adamgreen/NeoPixelTree/images/20181011-01.gif

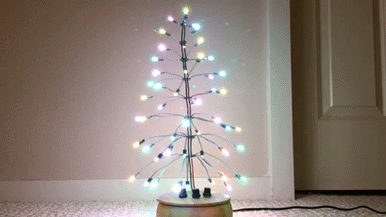
images/20181011-01.gif
