adamgreen/NeoPixelTree/images/20160401-01.JPG

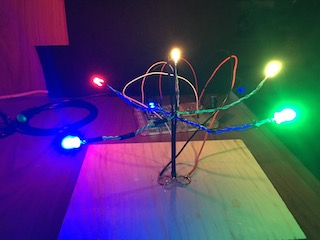
images/20160401-01.JPG
