adamgreen/NeoPixelTree/docs/AdafruitLabelledPhotoOf5mmNeoPixelLED_1938-05.jpg

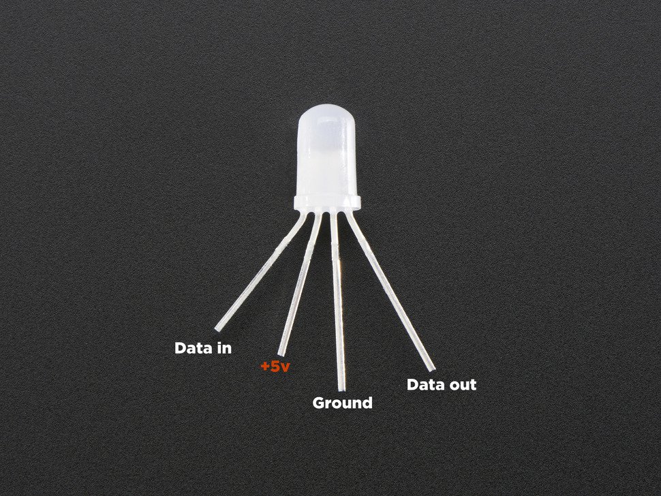
docs/AdafruitLabelledPhotoOf5mmNeoPixelLED_1938-05.jpg
