adamgreen/NeoPixelTree/hardware/Prototype.png

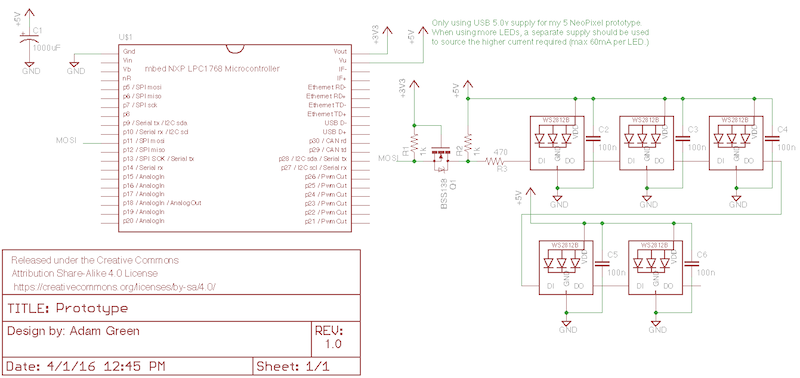
hardware/Prototype.png
