adamgreen/NeoPixelTree/images/20160401-02.GIF

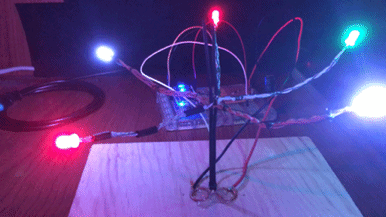
images/20160401-02.GIF
