adamgreen/NeoPixelTree/images/20160407-01.png

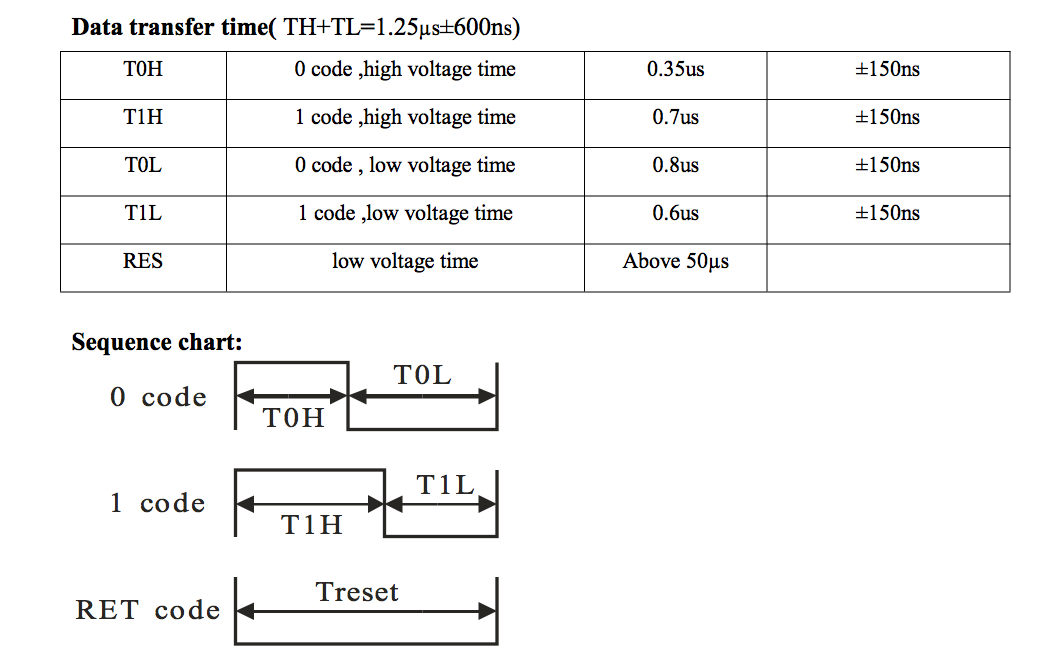
images/20160407-01.png
