adamgreen/NeoPixelTree/images/20160407-02.png

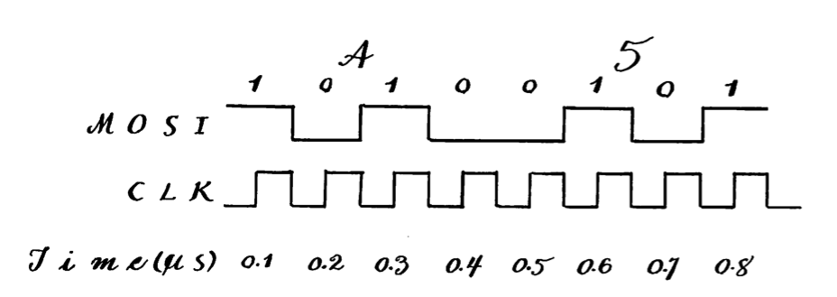
images/20160407-02.png
