adamgreen/NeoPixelTree/images/20160407-03.png

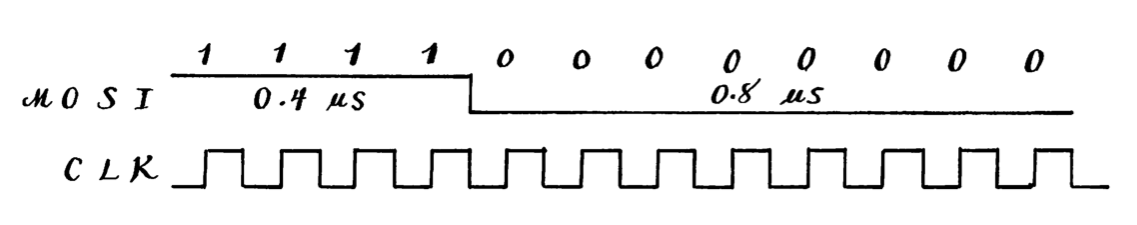
images/20160407-03.png
