adamgreen/NeoPixelTree/hardware/Prototype.pdf

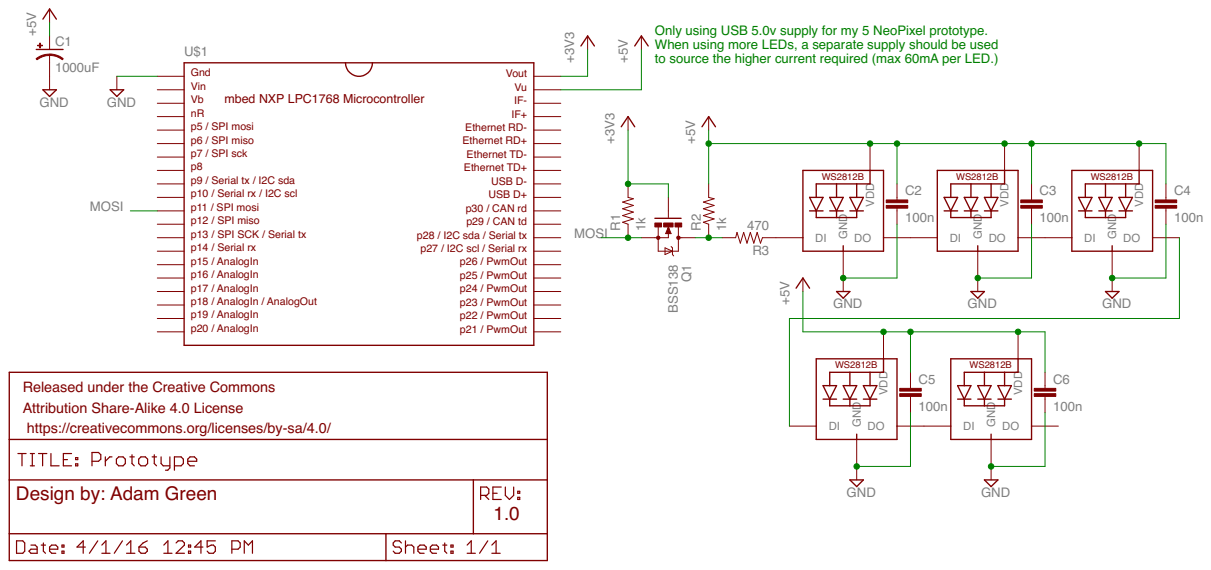
[picture p9: page 1]

Only using USB 5.0v supply for my 5 NeoPixel prototype. When using more LEDs, a separate supply should be used

to source the higher current required (max 60mA per LED.)

p5 / SPI mosi p6 / SPI miso

IF+ Ethernet RD- Ethernet RD+ Ethernet TD- Ethernet TD+ USB D- USB D+

p9 / Serial tx / I2C sda
p10 / Serial rx / I2C scl p11 / SPI mosi p12 / SPI miso

p21 / PwmOut p22 / PwmOut p23 / PwmOut p24 / PwmOut p25 / PwmOut p26 / PwmOut p27 / I2C scl / Serial rx p28 / I2C sda / Serial tx p29 / CAN td

p13 / SPI SCK / Serial tx p14 / Serial rx p15 / AnalogIn

https://creativecommons.org/licenses/by-sa/4.0/ Design by: Adam Green
