adamgreen/NeoPixelTree/hardware/TrunkBus5.brd

## EAGLE design hardware/TrunkBus5.brd (2018-04-29)

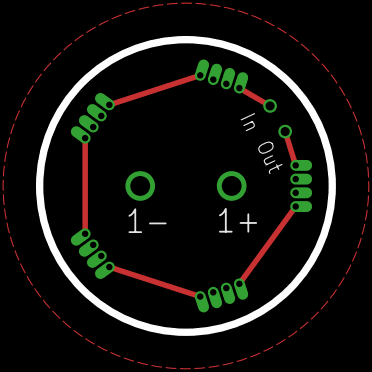
[picture p10: board TrunkBus5.brd from above]

Board: 2 copper layers, 16.3 x 16.3 mm, 8 parts (0 on the bottom side), 8 nets.

Parts:
E$1: NEOPIXEL_TRUNK_2WIRE
E$5, E$6, E$7, E$8, E$10: NEOPIXEL_BRANCH_4WIRE
E$12, E$13: NEOPIXEL_26AWG_HOLE

Connections:
5V: E$1.P$1, E$5.P$1, E$6.P$1, E$7.P$1, E$8.P$1, E$10.P$1
GND: E$1.P$2, E$5.P$2, E$6.P$2, E$7.P$2, E$8.P$2, E$10.P$2
S$1: E$8.P$4, E$10.P$3
S$2: E$10.P$4, E$12.P$1
S$4: E$5.P$3, E$13.P$1
S$7: E$5.P$4, E$6.P$3
S$8: E$6.P$4, E$7.P$3
S$10: E$7.P$4, E$8.P$3
