adamgreen/NeoPixelTree/hardware/TrunkBus3.brd

## EAGLE design hardware/TrunkBus3.brd (2018-04-29)

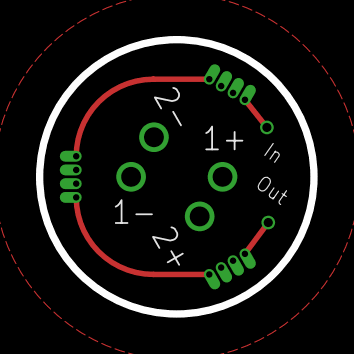
[picture p11: board TrunkBus3.brd from above]

Board: 2 copper layers, 15.2 x 15.2 mm, 7 parts (0 on the bottom side), 6 nets.

Parts:
E$1, E$11: NEOPIXEL_TRUNK_2WIRE
E$2, E$6, E$8: NEOPIXEL_BRANCH_4WIRE
E$12, E$13: NEOPIXEL_26AWG_HOLE

Connections:
5V: E$1.P$1, E$2.P$1, E$6.P$1, E$8.P$1, E$11.P$1
GND: E$1.P$2, E$2.P$2, E$6.P$2, E$8.P$2, E$11.P$2
S$1: E$8.P$4, E$12.P$1
S$2: E$2.P$3, E$13.P$1
S$4: E$2.P$4, E$6.P$3
S$8: E$6.P$4, E$8.P$3
