adamgreen/NeoPixelTree/hardware/LedHolder.brd

## EAGLE design hardware/LedHolder.brd (2018-03-23)

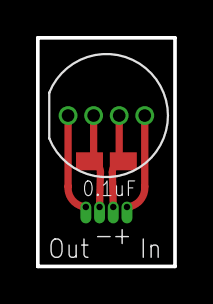
[picture p12: board LedHolder.brd from above]

Board: 2 copper layers, 7.6 x 12.7 mm, 3 parts (0 on the bottom side), 4 nets.

Parts:
E$1: NEOPIXEL_5MM_TH
E$2: NEOPIXEL_BRANCH_4WIRE
E$3: 0.1uF; R0805W

Connections:
S$1: E$1.GROUND, E$2.P$1, E$3.1
S$2: E$1.5V, E$2.P$2, E$3.2
S$3: E$1.DATA_OUT, E$2.P$3
S$4: E$1.DATA_IN, E$2.P$4
