adamgreen/NeoPixelTree/firmware/main.cpp

/* Copyright (C) 2018  Adam Green (https://github.com/adamgreen)

   Licensed under the Apache License, Version 2.0 (the "License");
   you may not use this file except in compliance with the License.
   You may obtain a copy of the License at

       http://www.apache.org/licenses/LICENSE-2.0

   Unless required by applicable law or agreed to in writing, software
   distributed under the License is distributed on an "AS IS" BASIS,
   WITHOUT WARRANTIES OR CONDITIONS OF ANY KIND, either express or implied.
   See the License for the specific language governing permissions and
   limitations under the License.
*/
#include <mbed.h>
#include "Animation.h"
#include "Encoders.h"
#include "NeoPixel.h"


#define LED_COUNT                           50
#define SECONDS_BETWEEN_ANIMATION_SWITCH    30
#define DUMP_COUNTERS                       0

#define BRIGHTNESS_MIN                      1
#define BRIGHTNESS_MAX                      255
#define BRIGHTNESS_DEFAULT                  128
#define BRIGHTNESS_DELTA                    1

#define DELAY_MIN                           125
#define DELAY_MAX                           1000
#define DELAY_DEFAULT                       250
#define DELAY_DELTA                         5

#define ARRAY_SIZE(X) (sizeof(X)/sizeof(X[0]))

// The animations that I currently have defined for this sample.
enum Animations
{
    Solid_White,
    Solid_Red,
    Solid_Green,
    Solid_Blue_White,
    Solid_Red_Green,
    Solid_Red_Green_White,
    Solid_Red_Orange_Yellow_Green_Blue,
    Chase_Blue_White,
    Chase_Red_Green,
    Chase_Red_Green_White,
    Chase_Red_Orange_Yellow_Green_Blue,
    Throbbing_Red,
    Throbbing_Green,
    Throbbing_White,
    Fade_Blue_White,
    Fade_Red_Green,
    Fade_Red_Green_White,
    Fade_Red_Orange_Yellow_Green_Blue,
    Fade_Rainbow,
    Twinkle_White,
    Twinkle_Red,
    Twinkle_Green,
    Twinkle_AnyColor,
    Twinkle_Snow,
    Running_Lights,
    Meteor,
    Candle_Flicker,
    Max_Animation
};

// Should we advance to next or previous animation.
enum AdvanceMode
{
    Advance_Next,
    Advance_Prev
};

static Animations        g_currAnimation = Solid_White;
static bool              g_demoMode = true;
static IPixelUpdate*     g_pPixelUpdate;
static int16_t           g_brightness = BRIGHTNESS_DEFAULT;
static int32_t           g_delay = DELAY_DEFAULT;
static Encoder           g_encoderPattern(p11, p12, p17);
static Encoder           g_encoderSpeed(p13, p14, p18);
static Encoder           g_encoderBrightness(p15, p16, p19);


// Function Prototypes.
static void updateAnimation();
static void advanceToNextAnimation(AdvanceMode advance);


int main()
{
    uint32_t lastFlipCount = 0;
    uint32_t lastSetCount = 0;
    static   DigitalOut myled(LED1);
    static   NeoPixel   ledControl(LED_COUNT, p5);
    static   Timer      timer;
    static   Timer      ledTimer;

    updateAnimation();
    ledControl.start();

    timer.start();
    ledTimer.start();

    while(1)
    {
        if (timer.read_ms() > SECONDS_BETWEEN_ANIMATION_SWITCH * 1000)
        {
            uint32_t currSetCount = ledControl.getSetCount();
            uint32_t setCount =  currSetCount - lastSetCount;
            uint32_t currFlipCount = ledControl.getFlipCount();
            uint32_t flipCount = currFlipCount - lastFlipCount;

            if (DUMP_COUNTERS)
            {
                printf("flips: %lu/sec    sets: %lu/sec\n",
                       flipCount / SECONDS_BETWEEN_ANIMATION_SWITCH,
                       setCount / SECONDS_BETWEEN_ANIMATION_SWITCH);
            }

            timer.reset();
            lastSetCount = currSetCount;
            lastFlipCount = currFlipCount;

            // Only advance to next animation if in demo mode.
            if (g_demoMode)
            {
                advanceToNextAnimation(Advance_Next);
            }
        }
        g_pPixelUpdate->updatePixels(ledControl);

        if (ledTimer.read_ms() >= 250)
        {
            myled = !myled;
            ledTimer.reset();
        }

        EncoderState state;
        if (g_encoderPattern.sample(&state))
        {
            if (state.count > 0)
            {
                g_demoMode = false;
                advanceToNextAnimation(Advance_Next);
            }
            else if (state.count < 0)
            {
                g_demoMode = false;
                advanceToNextAnimation(Advance_Prev);
            }
            if (state.isPressed)
            {
                g_demoMode = true;
            }
        }

        if (g_encoderSpeed.sample(&state))
        {
            // Increasing count on speed encoder will cause a decrease in delay so the logic is inverted from the
            // other encoders.
            if (state.count < 0)
            {
                g_delay -= DELAY_DELTA * state.count;
                if (g_delay > DELAY_MAX)
                {
                    g_delay = DELAY_MAX;
                }
            }
            else if (state.count > 0)
            {
                g_delay -= DELAY_DELTA * state.count;
                if (g_delay < DELAY_MIN)
                {
                    g_delay = DELAY_MIN;
                }
            }
            if (state.isPressed)
            {
                g_delay = DELAY_DEFAULT;
            }

            updateAnimation();
        }

        if (g_encoderBrightness.sample(&state))
        {
            if (state.count > 0)
            {
                g_brightness += BRIGHTNESS_DELTA * state.count;
                if (g_brightness > BRIGHTNESS_MAX)
                {
                    g_brightness = BRIGHTNESS_MAX;
                }
            }
            else if (state.count < 0)
            {
                g_brightness += BRIGHTNESS_DELTA * state.count;
                if (g_brightness < BRIGHTNESS_MIN)
                {
                    g_brightness = BRIGHTNESS_MIN;
                }
            }
            if (state.isPressed)
            {
                g_brightness = BRIGHTNESS_DEFAULT;
            }

            updateAnimation();
        }
    }
}

static void updateAnimation()
{
    static Animation<LED_COUNT>        animation;
    static TwinkleAnimation<LED_COUNT> twinkle;
    static TwinkleProperties           twinkleProperties;
    static FlickerAnimation<LED_COUNT> flicker;
    static FlickerProperties           flickerProperties;
    static RunningLightsAnimation<LED_COUNT> runningLights;
    static MeteorProperties            meteorProperties;
    static MeteorAnimation<LED_COUNT>  meteor;
    static RGBData                     pixels1[LED_COUNT];
    static RGBData                     pixels2[LED_COUNT];
    static RGBData                     pixels3[LED_COUNT];
    static RGBData                     pixels4[LED_COUNT];
    static RGBData                     pixels5[LED_COUNT];
    static AnimationKeyFrame           keyFrames[5];

    // Use the natural logarithm of brightness setting to create a smoother gradient.
    uint8_t brightness = logOfBrightness(g_brightness);

    switch (g_currAnimation)
    {
    case Solid_White:
        {
            RGBData pattern[] = { WHITE };
            changeBrightness(pattern, ARRAY_SIZE(pattern), brightness);
            createRepeatingPixelPattern(pixels1, ARRAY_SIZE(pixels1), pattern, ARRAY_SIZE(pattern));
            keyFrames[0] = {pixels1, 0x7FFFFFFF, false};
            animation.setKeyFrames(keyFrames, 1);
            g_pPixelUpdate = &animation;
            break;
        }
    case Solid_Red:
        {
            RGBData pattern[] = { RED };
            changeBrightness(pattern, ARRAY_SIZE(pattern), brightness);
            createRepeatingPixelPattern(pixels1, ARRAY_SIZE(pixels1), pattern, ARRAY_SIZE(pattern));
            keyFrames[0] = {pixels1, 0x7FFFFFFF, false};
            animation.setKeyFrames(keyFrames, 1);
            g_pPixelUpdate = &animation;
            break;
        }
    case Solid_Green:
        {
            RGBData pattern[] = { GREEN };
            changeBrightness(pattern, ARRAY_SIZE(pattern), brightness);
            createRepeatingPixelPattern(pixels1, ARRAY_SIZE(pixels1), pattern, ARRAY_SIZE(pattern));
            keyFrames[0] = {pixels1, 0x7FFFFFFF, false};
            animation.setKeyFrames(keyFrames, 1);
            g_pPixelUpdate = &animation;
            break;
        }
    case Solid_Blue_White:
        {
            RGBData pattern[] = { BLUE, WHITE };
            changeBrightness(pattern, ARRAY_SIZE(pattern), brightness);
            createRepeatingPixelPattern(pixels1, ARRAY_SIZE(pixels1), pattern, ARRAY_SIZE(pattern));
            keyFrames[0] = {pixels1, 0x7FFFFFFF, false};
            animation.setKeyFrames(keyFrames, 1);
            g_pPixelUpdate = &animation;
            break;
        }
    case Solid_Red_Green:
        {
            RGBData pattern[] = { RED, GREEN };
            changeBrightness(pattern, ARRAY_SIZE(pattern), brightness);
            createRepeatingPixelPattern(pixels1, ARRAY_SIZE(pixels1), pattern, ARRAY_SIZE(pattern));
            keyFrames[0] = {pixels1, 0x7FFFFFFF, false};
            animation.setKeyFrames(keyFrames, 1);
            g_pPixelUpdate = &animation;
            break;
        }
    case Solid_Red_Green_White:
        {
            RGBData pattern[] = { RED, GREEN, WHITE };
            changeBrightness(pattern, ARRAY_SIZE(pattern), brightness);
            createRepeatingPixelPattern(pixels1, ARRAY_SIZE(pixels1), pattern, ARRAY_SIZE(pattern));
            keyFrames[0] = {pixels1, 0x7FFFFFFF, false};
            animation.setKeyFrames(keyFrames, 1);
            g_pPixelUpdate = &animation;
            break;
        }
    case Solid_Red_Orange_Yellow_Green_Blue:
        {
            RGBData pattern[] = { RED, DARK_ORANGE, YELLOW, GREEN, BLUE };
            changeBrightness(pattern, ARRAY_SIZE(pattern), brightness);
            createRepeatingPixelPattern(pixels1, ARRAY_SIZE(pixels1), pattern, ARRAY_SIZE(pattern));
            keyFrames[0] = {pixels1, 0x7FFFFFFF, false};
            animation.setKeyFrames(keyFrames, 1);
            g_pPixelUpdate = &animation;
            break;
        }
    case Chase_Blue_White:
        {
            RGBData pattern1[] = { BLUE, WHITE };
            RGBData pattern2[] = { WHITE, BLUE };
            changeBrightness(pattern1, ARRAY_SIZE(pattern1), brightness);
            changeBrightness(pattern2, ARRAY_SIZE(pattern2), brightness);
            createRepeatingPixelPattern(pixels1, ARRAY_SIZE(pixels1), pattern1, ARRAY_SIZE(pattern1));
            createRepeatingPixelPattern(pixels2, ARRAY_SIZE(pixels2), pattern2, ARRAY_SIZE(pattern2));
            keyFrames[0] = {pixels1, g_delay, false};
            keyFrames[1] = {pixels2, g_delay, false};
            animation.setKeyFrames(keyFrames, 2);
            g_pPixelUpdate = &animation;
            break;
        }
    case Chase_Red_Green:
        {
            RGBData pattern1[] = { RED, GREEN };
            RGBData pattern2[] = { GREEN, RED };
            changeBrightness(pattern1, ARRAY_SIZE(pattern1), brightness);
            changeBrightness(pattern2, ARRAY_SIZE(pattern2), brightness);
            createRepeatingPixelPattern(pixels1, ARRAY_SIZE(pixels1), pattern1, ARRAY_SIZE(pattern1));
            createRepeatingPixelPattern(pixels2, ARRAY_SIZE(pixels2), pattern2, ARRAY_SIZE(pattern2));
            keyFrames[0] = {pixels1, g_delay, false};
            keyFrames[1] = {pixels2, g_delay, false};
            animation.setKeyFrames(keyFrames, 2);
            g_pPixelUpdate = &animation;
            break;
        }
    case Chase_Red_Green_White:
        {
            RGBData pattern1[] = { RED, GREEN, WHITE };
            RGBData pattern2[] = { WHITE, RED, GREEN };
            RGBData pattern3[] = { GREEN, WHITE, RED };
            changeBrightness(pattern1, ARRAY_SIZE(pattern1), brightness);
            changeBrightness(pattern2, ARRAY_SIZE(pattern2), brightness);
            changeBrightness(pattern3, ARRAY_SIZE(pattern3), brightness);
            createRepeatingPixelPattern(pixels1, ARRAY_SIZE(pixels1), pattern1, ARRAY_SIZE(pattern1));
            createRepeatingPixelPattern(pixels2, ARRAY_SIZE(pixels2), pattern2, ARRAY_SIZE(pattern2));
            createRepeatingPixelPattern(pixels3, ARRAY_SIZE(pixels3), pattern3, ARRAY_SIZE(pattern3));
            keyFrames[0] = {pixels1, g_delay, false};
            keyFrames[1] = {pixels2, g_delay, false};
            keyFrames[2] = {pixels3, g_delay, false};
            animation.setKeyFrames(keyFrames, 3);
            g_pPixelUpdate = &animation;
            break;
        }
    case Chase_Red_Orange_Yellow_Green_Blue:
        {
            RGBData pattern1[] = { RED, DARK_ORANGE, YELLOW, GREEN, BLUE };
            RGBData pattern2[] = { BLUE, RED, DARK_ORANGE, YELLOW, GREEN };
            RGBData pattern3[] = { GREEN, BLUE, RED, DARK_ORANGE, YELLOW };
            RGBData pattern4[] = { YELLOW, GREEN, BLUE, RED, DARK_ORANGE };
            RGBData pattern5[] = { DARK_ORANGE, YELLOW, GREEN, BLUE, RED };
            changeBrightness(pattern1, ARRAY_SIZE(pattern1), brightness);
            changeBrightness(pattern2, ARRAY_SIZE(pattern2), brightness);
            changeBrightness(pattern3, ARRAY_SIZE(pattern3), brightness);
            changeBrightness(pattern4, ARRAY_SIZE(pattern4), brightness);
            changeBrightness(pattern5, ARRAY_SIZE(pattern5), brightness);
            createRepeatingPixelPattern(pixels1, ARRAY_SIZE(pixels1), pattern1, ARRAY_SIZE(pattern1));
            createRepeatingPixelPattern(pixels2, ARRAY_SIZE(pixels2), pattern2, ARRAY_SIZE(pattern2));
            createRepeatingPixelPattern(pixels3, ARRAY_SIZE(pixels3), pattern3, ARRAY_SIZE(pattern3));
            createRepeatingPixelPattern(pixels4, ARRAY_SIZE(pixels4), pattern4, ARRAY_SIZE(pattern4));
            createRepeatingPixelPattern(pixels5, ARRAY_SIZE(pixels5), pattern5, ARRAY_SIZE(pattern5));
            keyFrames[0] = {pixels1, g_delay, false};
            keyFrames[1] = {pixels2, g_delay, false};
            keyFrames[2] = {pixels3, g_delay, false};
            keyFrames[3] = {pixels4, g_delay, false};
            keyFrames[4] = {pixels5, g_delay, false};
            animation.setKeyFrames(keyFrames, 5);
            g_pPixelUpdate = &animation;
            break;
        }
    case Throbbing_Red:
        {
            RGBData pattern1[] = { RGBData(8, 0, 0) };
            RGBData pattern2[] = { RGBData(255, 0, 0) };
            changeBrightness(pattern1, ARRAY_SIZE(pattern1), brightness);
            changeBrightness(pattern2, ARRAY_SIZE(pattern2), brightness);
            createRepeatingPixelPattern(pixels1, ARRAY_SIZE(pixels1), pattern1, ARRAY_SIZE(pattern1));
            createRepeatingPixelPattern(pixels2, ARRAY_SIZE(pixels2), pattern2, ARRAY_SIZE(pattern2));
            keyFrames[0] = {pixels1, g_delay * 4, true};
            keyFrames[1] = {pixels2, g_delay * 4, true};
            animation.setKeyFrames(keyFrames, 2);
            g_pPixelUpdate = &animation;
            break;
        }
    case Throbbing_Green:
        {
            RGBData pattern1[] = { RGBData(0, 8, 0) };
            RGBData pattern2[] = { RGBData(0, 255, 0) };
            changeBrightness(pattern1, ARRAY_SIZE(pattern1), brightness);
            changeBrightness(pattern2, ARRAY_SIZE(pattern2), brightness);
            createRepeatingPixelPattern(pixels1, ARRAY_SIZE(pixels1), pattern1, ARRAY_SIZE(pattern1));
            createRepeatingPixelPattern(pixels2, ARRAY_SIZE(pixels2), pattern2, ARRAY_SIZE(pattern2));
            keyFrames[0] = {pixels1, g_delay * 4, true};
            keyFrames[1] = {pixels2, g_delay * 4, true};
            animation.setKeyFrames(keyFrames, 2);
            g_pPixelUpdate = &animation;
            break;
        }
    case Throbbing_White:
        {
            RGBData pattern1[] = { RGBData(8, 8, 8) };
            RGBData pattern2[] = { RGBData(255, 255, 255) };
            changeBrightness(pattern1, ARRAY_SIZE(pattern1), brightness);
            changeBrightness(pattern2, ARRAY_SIZE(pattern2), brightness);
            createRepeatingPixelPattern(pixels1, ARRAY_SIZE(pixels1), pattern1, ARRAY_SIZE(pattern1));
            createRepeatingPixelPattern(pixels2, ARRAY_SIZE(pixels2), pattern2, ARRAY_SIZE(pattern2));
            keyFrames[0] = {pixels1, g_delay * 4, true};
            keyFrames[1] = {pixels2, g_delay * 4, true};
            animation.setKeyFrames(keyFrames, 2);
            g_pPixelUpdate = &animation;
            break;
        }
    case Fade_Blue_White:
        {
            RGBData pattern1[] = { BLUE, WHITE };
            RGBData pattern2[] = { WHITE, BLUE };
            changeBrightness(pattern1, ARRAY_SIZE(pattern1), brightness);
            changeBrightness(pattern2, ARRAY_SIZE(pattern2), brightness);
            createRepeatingPixelPattern(pixels1, ARRAY_SIZE(pixels1), pattern1, ARRAY_SIZE(pattern1));
            createRepeatingPixelPattern(pixels2, ARRAY_SIZE(pixels2), pattern2, ARRAY_SIZE(pattern2));
            keyFrames[0] = {pixels1, g_delay, true};
            keyFrames[1] = {pixels2, g_delay, true};
            animation.setKeyFrames(keyFrames, 2);
            g_pPixelUpdate = &animation;
            break;
        }
    case Fade_Red_Green:
        {
            RGBData pattern1[] = { RED, GREEN };
            RGBData pattern2[] = { GREEN, RED };
            changeBrightness(pattern1, ARRAY_SIZE(pattern1), brightness);
            changeBrightness(pattern2, ARRAY_SIZE(pattern2), brightness);
            createRepeatingPixelPattern(pixels1, ARRAY_SIZE(pixels1), pattern1, ARRAY_SIZE(pattern1));
            createRepeatingPixelPattern(pixels2, ARRAY_SIZE(pixels2), pattern2, ARRAY_SIZE(pattern2));
            keyFrames[0] = {pixels1, g_delay, true};
            keyFrames[1] = {pixels2, g_delay, true};
            animation.setKeyFrames(keyFrames, 2);
            g_pPixelUpdate = &animation;
            break;
        }
    case Fade_Red_Green_White:
        {
            RGBData pattern1[] = { RED, GREEN, WHITE };
            RGBData pattern2[] = { WHITE, RED, GREEN };
            RGBData pattern3[] = { GREEN, WHITE, RED };
            changeBrightness(pattern1, ARRAY_SIZE(pattern1), brightness);
            changeBrightness(pattern2, ARRAY_SIZE(pattern2), brightness);
            changeBrightness(pattern3, ARRAY_SIZE(pattern3), brightness);
            createRepeatingPixelPattern(pixels1, ARRAY_SIZE(pixels1), pattern1, ARRAY_SIZE(pattern1));
            createRepeatingPixelPattern(pixels2, ARRAY_SIZE(pixels2), pattern2, ARRAY_SIZE(pattern2));
            createRepeatingPixelPattern(pixels3, ARRAY_SIZE(pixels3), pattern3, ARRAY_SIZE(pattern3));
            keyFrames[0] = {pixels1, g_delay, true};
            keyFrames[1] = {pixels2, g_delay, true};
            keyFrames[2] = {pixels3, g_delay, true};
            animation.setKeyFrames(keyFrames, 3);
            g_pPixelUpdate = &animation;
            break;
        }
    case Fade_Red_Orange_Yellow_Green_Blue:
        {
            RGBData pattern1[] = { RED, DARK_ORANGE, YELLOW, GREEN, BLUE };
            RGBData pattern2[] = { BLUE, RED, DARK_ORANGE, YELLOW, GREEN };
            RGBData pattern3[] = { GREEN, BLUE, RED, DARK_ORANGE, YELLOW };
            RGBData pattern4[] = { YELLOW, GREEN, BLUE, RED, DARK_ORANGE };
            RGBData pattern5[] = { DARK_ORANGE, YELLOW, GREEN, BLUE, RED };
            changeBrightness(pattern1, ARRAY_SIZE(pattern1), brightness);
            changeBrightness(pattern2, ARRAY_SIZE(pattern2), brightness);
            changeBrightness(pattern3, ARRAY_SIZE(pattern3), brightness);
            changeBrightness(pattern4, ARRAY_SIZE(pattern4), brightness);
            changeBrightness(pattern5, ARRAY_SIZE(pattern5), brightness);
            createRepeatingPixelPattern(pixels1, ARRAY_SIZE(pixels1), pattern1, ARRAY_SIZE(pattern1));
            createRepeatingPixelPattern(pixels2, ARRAY_SIZE(pixels2), pattern2, ARRAY_SIZE(pattern2));
            createRepeatingPixelPattern(pixels3, ARRAY_SIZE(pixels3), pattern3, ARRAY_SIZE(pattern3));
            createRepeatingPixelPattern(pixels4, ARRAY_SIZE(pixels4), pattern4, ARRAY_SIZE(pattern4));
            createRepeatingPixelPattern(pixels5, ARRAY_SIZE(pixels5), pattern5, ARRAY_SIZE(pattern5));
            keyFrames[0] = {pixels1, g_delay, true};
            keyFrames[1] = {pixels2, g_delay, true};
            keyFrames[2] = {pixels3, g_delay, true};
            keyFrames[3] = {pixels4, g_delay, true};
            keyFrames[4] = {pixels5, g_delay, true};
            animation.setKeyFrames(keyFrames, 5);
            g_pPixelUpdate = &animation;
            break;
        }
    case Fade_Rainbow:
        {
            RGBData pattern1[] = { RED };
            RGBData pattern2[] = { VIOLET };
            changeBrightness(pattern1, ARRAY_SIZE(pattern1), brightness);
            changeBrightness(pattern2, ARRAY_SIZE(pattern2), brightness);
            createInterpolatedPixelPattern(pixels1, ARRAY_SIZE(pixels1), pattern1, pattern2);
            createInterpolatedPixelPattern(pixels2, ARRAY_SIZE(pixels2), pattern2, pattern1);
            keyFrames[0] = {pixels1, g_delay * 4, true};
            keyFrames[1] = {pixels2, g_delay * 4, true};
            animation.setKeyFrames(keyFrames, 2);
            g_pPixelUpdate = &animation;
            break;
        }
    case Twinkle_White:
        {
            twinkleProperties.lifetimeMin = g_delay / 2;
            twinkleProperties.lifetimeMax = g_delay;
            twinkleProperties.probability = 250;
            twinkleProperties.hueMin = 0;
            twinkleProperties.hueMax = 0;
            twinkleProperties.saturationMin = 0;
            twinkleProperties.saturationMax = 0;
            twinkleProperties.valueMin = brightness / 2;
            twinkleProperties.valueMax = brightness;
            twinkleProperties.hsvBackground = HSVData(0, 0, 0);
            twinkle.setProperties(&twinkleProperties);
            g_pPixelUpdate = &twinkle;
            break;
        }
    case Twinkle_Red:
        {
            twinkleProperties.lifetimeMin = g_delay / 2;
            twinkleProperties.lifetimeMax = g_delay;
            twinkleProperties.probability = 250;
            twinkleProperties.hueMin = 0;
            twinkleProperties.hueMax = 0;
            twinkleProperties.saturationMin = 255;
            twinkleProperties.saturationMax = 255;
            twinkleProperties.valueMin = brightness / 2;
            twinkleProperties.valueMax = brightness;
            twinkleProperties.hsvBackground = HSVData(0, 255, 0);
            twinkle.setProperties(&twinkleProperties);
            g_pPixelUpdate = &twinkle;
            break;
        }
    case Twinkle_Green:
        {
            twinkleProperties.lifetimeMin = g_delay / 2;
            twinkleProperties.lifetimeMax = g_delay;
            twinkleProperties.probability = 250;
            twinkleProperties.hueMin = 84;
            twinkleProperties.hueMax = 84;
            twinkleProperties.saturationMin = 255;
            twinkleProperties.saturationMax = 255;
            twinkleProperties.valueMin = brightness / 2;
            twinkleProperties.valueMax = brightness;
            twinkleProperties.hsvBackground = HSVData(84, 255, 0);
            twinkle.setProperties(&twinkleProperties);
            g_pPixelUpdate = &twinkle;
            break;
        }
    case Twinkle_AnyColor:
        {
            twinkleProperties.lifetimeMin = g_delay / 2;
            twinkleProperties.lifetimeMax = g_delay;
            twinkleProperties.probability = 250;
            twinkleProperties.hueMin = 0;
            twinkleProperties.hueMax = 255;
            twinkleProperties.saturationMin = 0;
            twinkleProperties.saturationMax = 255;
            twinkleProperties.valueMin = brightness / 2;
            twinkleProperties.valueMax = brightness;
            twinkleProperties.hsvBackground = HSVData(0, 0, 0);
            twinkle.setProperties(&twinkleProperties);
            g_pPixelUpdate = &twinkle;
            break;
        }
    case Twinkle_Snow:
        {
            twinkleProperties.lifetimeMin = g_delay / 2;
            twinkleProperties.lifetimeMax = g_delay;
            twinkleProperties.probability = 250;
            twinkleProperties.hueMin = 0;
            twinkleProperties.hueMax = 0;
            twinkleProperties.saturationMin = 0;
            twinkleProperties.saturationMax = 0;
            twinkleProperties.valueMin = brightness / 2;
            twinkleProperties.valueMax = brightness;
            twinkleProperties.hsvBackground = HSVData(0x00, 0x00, brightness >= 10 ? brightness / 10 : 1);
            twinkle.setProperties(&twinkleProperties);
            g_pPixelUpdate = &twinkle;
            break;
        }
    case Running_Lights:
        {
            HSVData hsv;
            hsv.hue = 0;
            hsv.saturation = 0;
            hsv.value = brightness;
            runningLights.setProperties(&hsv, g_delay/4);
            g_pPixelUpdate = &runningLights;
            break;
        }
    case Meteor:
        {
            meteorProperties.brightColor.red = brightness;
            meteorProperties.brightColor.green = brightness;
            meteorProperties.brightColor.blue = brightness;
            meteorProperties.size = 10;
            meteorProperties.trailDecay = 64;
            meteorProperties.isDecayRandom = true;
            meteorProperties.delay = g_delay / 5;
            meteor.setProperties(&meteorProperties);
            g_pPixelUpdate = &meteor;
            break;
        }
    case Candle_Flicker:
        {
            flickerProperties.timeMin = 2;
            flickerProperties.timeMax = 3;
            flickerProperties.stayBrightFactor = 100;
            flickerProperties.brightnessMin = brightness / 2;
            flickerProperties.brightnessMax = brightness;
            flickerProperties.baseRGBColour = DARK_ORANGE;
            flicker.setProperties(&flickerProperties);
            g_pPixelUpdate = &flicker;
            break;
        }
    default:
        {
            RGBData pattern = BLACK;
            createRepeatingPixelPattern(pixels1, ARRAY_SIZE(pixels1), &pattern, 1);
            keyFrames[0] = {pixels1, 0x7FFFFFFF, false};
            animation.setKeyFrames(keyFrames, 1);
            g_pPixelUpdate = &animation;
            break;
        }
    }
}

static void advanceToNextAnimation(AdvanceMode advance)
{
    if (advance == Advance_Next)
    {
        g_currAnimation = (Animations)(g_currAnimation + 1);
        if (g_currAnimation >= Max_Animation)
        {
            g_currAnimation = Solid_White;
        }
    }
    else
    {
        if (g_currAnimation == Solid_White)
        {
            g_currAnimation = Max_Animation;
        }
        g_currAnimation = (Animations)(g_currAnimation - 1);
    }
    updateAnimation();
}
