adamgreen/NeoPixelTree/(commit log)

2016-03-27 GPDMA/SPI based updates of NeoPixels now working
    This commit is a checkpoint where the code is now able to use the
    GPDMA/SPI peripherals on the LPC17xx to automatically send out the
    required single wire waveform for the WS2812 based NeoPixels. The CPU
    is only used to convert the desired LED RGB values to a bitstream that
    can be sent out over the SPI MOSI pin to generate the expected WS2812
    waveform. This saves CPU cycles to be used for running animations.
    The output from this test is a static pattern to just make sure that
    the correct LEDs get set to the correct colour. Animations will be
    added in future commits.
    [GPDMA.c, GPDMA.h, NeoPixel.cpp, NeoPixel.h, main.cpp]
2016-03-27 I don't need interlocked operations for this driver
    A previous implementation that I was working on needed to increment the
    frame counter in an interlocked fashion but this one doesn't.
    [NeoPixel.cpp]
2016-03-27 Remove some old debug code from main.cpp
    I had some leftover debug code in main.cpp where I was verifying that
    both front buffers were being updated correctly when client doesn't
    provide a new frame on very frame flip.
    [main.cpp]
2016-03-27 Add twinkling animation
    I added an IPixelUpdate interface which the already existing Animation
    class now implements and so does the new TwinkleAnimation class. The
    main program then just maintains a IPixelUpdate pointer to the current
    animation engine and calls its updatePixels() method on each iteration
    through its main loop.
2016-03-27 Make animations templated on pixel count
    The animation classes no longer need to dynamically allocate pixel
    arrays. Now they take the pixel count as a template parameter and
    define an array within the class which is big enough to hold the
    pixels.
    [Animation.cpp, Animation.h, main.cpp]
2016-03-29 Add back buffer support
    Previously the main thread would wait for the current front buffer to
    be sent and then it would fill that front buffer in while the other was
    being sent. This caused the CPU on average to wait half of a frame
    period each time it called NeoPixel::set().
    This new version has the main thread just filling in a separate
    back buffer. That back buffer will then be copied into the next front
    buffer to become available. This means the main thread only needs to
    wait if the previous backbuffer update hasn't yet been copied into the
    front buffer(s). The copy of the back buffer to the front buffer is
    started in the interrupt handler that is triggered when a front buffer
    has just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
2016-03-29 Add candle flicker animation
    This is the start of an animation that makes the LEDs flicker similar
    to how store bot LED candles flicker. The following webpage created by
    @cpldcpu provided a lot of inspiration for this animation:
    https://cpldcpu.wordpress.com/2016/01/05/reverse-engineering-a-real-candle/
    I also cleaned up some trailing whitespace in my logarithm table.
2016-04-01 Add schematic for current prototype
    This commit adds the Eagle schematic for the current 5 LED prototype
    that I am currently testing.
    [Prototype.sch]
2016-04-02 Photos of tree prototype
2016-04-02 Add BSS138 N-Channel MOSFET documentation
2016-04-03 SPI bit layout comments were incorrect
    They were incorrectly indicating that a high bit to be sent to the
    WS2812 would be represented with 8 high pixels rather than the actual
    7 used in the driver.
2016-04-08 Add images
    The first is a clip from page 4 of the WS2812 LED driver datasheet. It
    shows the bit timings for the WS2812 serial protocol.
    The rest are hand drawn timing diagrams for my SPI implementation of
    the WS2812 serial protocol.
2016-04-08 Update README
    Added notes describing how I use SPI to generate WS2812 bit timings.
2016-05-07 Add LED holder PCB design
    I sent this design off to OSHPark to have 3 made to see how they work
    out. I made no schematic and just jumped to the layout since it was so
    simple.
    [LedHolder.brd]
2017-02-08 LedHolder updates
    After getting back samples from the first version, I have decided to
    make a few changes for the next version:
    * Add an additional line to the top silkscreen to make the LED mounting
    orientation clearer as the LED silkscreen itself is a bit obfuscated
    by the holes themselves.
    * Expose more of the pad for the power supply lines. Currently the pad
    isn't exposed at all on the top surface (covered by solder mask).
    [LedHolder.brd]
2017-02-08 More LedHolder updates
    I switched the DataIn and DataOut connections to be through hole as
    well since the holes hold the wire in place to make it easier for
    soldering.
    [LedHolder.brd]
2018-02-03 Move NeoPixels to p5 from p11
    This makes room for using p11 as one of the rotary encoder pins as they
    need to be sequential LPC1768 pins.
2018-02-03 Initial encoder support
    I pulled existing LPC1768 quadature encoder code from my
    https://github.com/adamgreen/bb-8 project and then modified it to work
    with 3 rotary encoders (brightness, speed, and pattern) for this
    project.
    This is just an initial port. I will no doubt update it to make it more
    robust and more tolerant of bounce.
2018-02-04 Make rotary encoder code more robust
    This update was inspired by the following code from the Adafruit team:
    https://github.com/adafruit/Adafruit-Trinket-USB/blob/master/TrinketHidCombo/examples/TrinketVolumeKnob/TrinketVolumeKnob.ino
    It tracks the history of encoder state transitions that are seen
    between detent states. Once the encoder gets back to the detent state,
    the history can be queried to determine if it was more likely to have
    been rotated in a clockwise or counter clockwise direction.
2018-02-04 Read and clear encoder counts in 1 atomic operation
2018-02-08 Add rotary encoder button support
2018-02-09 Rewrite of rotary encoder filter
    I rewrote the rotary encoder code so that it first filters each encoder
    signal wire by only looking for pairs of clean HIGH (switch open)
    pulses and it then infers the length of the noisier LOW (switch closed)
    pulses. It returns the inferred LOW pulse and detected HIGH pulse back
    to the caller in a queue of length 2 containing the corresponding 2
    timestamped pulse descriptions.
    The higher level code walks the queues returned for each of its signal
    wires (A & B) to determine the direction of rotation. This works much
    better than the previous version of the code since the code just infers
    the LOW pulse (with all of its switch bounce) instead of trying to
    detec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
2018-02-09 Add back in press support
    The previous filtering rewrite only supported sampling of rotation.
    This commit adds back in support for detecting shaft presses.
2018-03-02 Bump LED count up to 50
    The plan is to have 50 LEDs on the final tree so I bumped the count in
    the firmware to match. Previously it was set to 5 which meant that I
    couldn't test the 9 branches that I have on my current prototype.
2018-03-02 Create new LED holder PCB
    The new PCB is rectangular and will extend horizontally from the end of
    the branch wires. The LED will be bent at 90 degrees after being
    soldered into this board so that it lays horizontally as well. I will
    finalize the design once I have the flat cable in hand (currently on
    order).
    [LedHolder.brd]
2018-03-02 Start of 9 branch trunk bus bar layout
    This is the board which will be used to connect the lowest two layers
    of the tree (with 9 branches each) to the tree trunk. I will finalize
    the design once I have the flat cable in hand (currently on order).
    [TrunkBus9.brd]
2018-03-07 Revision 1 of horizontal NeoPixel holder
    This is the PCB as ordered from OSHPark on 3/6/2018. The PCB is now
    routed and has updated text.
    [LedHolder.brd]
2018-03-07 Revision 1 of 9 branch trunk bus bar
    This is the PCB as ordered from OSHPark on 3/6/2018.
    [TrunkBus9.brd]
2018-03-23 Revision 2 of the latest boards
    Sent these revision 2 board off to OSHPark on March 23rd, 2018. I
    increased the drill sizes to accomodate the maximum of OSHPark's
    +/- 2.5mil drill tolerances. I also updated the 9 branch bus to
    fill top layer with 5V and move the DataIn/DataOut holes a bit to
    make room for the now larger ribbon cable holes.
    [LedHolder.brd, TrunkBus9.brd]
2018-04-29 Revision 1 of 3,5,6,7, and 8 branch trunk bus bars
    These are the PCBs as ordered from OSHPark on 4/28/2018.
    [TrunkBus3.brd, TrunkBus5.brd, TrunkBus6.brd, TrunkBus7.brd, TrunkBus8.brd]
2018-10-02 Encoder code cleanup
    * Renamed MINIMUM_LOW_TIME to MINIMUM_HIGH_TIME to better describe its
    actual usage.
    * Cleaned up comments to better describe the *_LAST state transition
    macros.
2018-10-03 Enable animation selection encoder
    The leftmost rotary encoder can now be used to select the animations:
    * Pressing the encoder places it in demo mode (the default mode) which
    iterates through and plays each animation for a set amount of time.
    * Clockwise rotation exits demo mode and selects the next animation in
    the sequence. Stays at this animation until the user moves the
    encoder again.
    * Counter clockwise rotation exits demo mode and selects the next
    animation in the sequence. Stays at this animation until the user
    moves the encoder again.
2018-10-04 Fix /0 error in rgbToHsv()
    I introduced a divide by zero bug by not just returning when some of
    HSV components were detected to be 0. This bug didn't exist in the
    original code from stackoverflow.
    [Pixel.h]
2018-10-04 Enable brightness selection encoder
    The rightmost rotary encoder can now be used to control the brightness
    of the LEDs. The brightness setting is applied to all supported
    animations.
    Other changes in this commit include:
    * I now default all of the animations to use 50% brightness and this
    seems to be plenty bright enough.
    * I bumped the time between animation switching in demo mode from 2
    seconds to 30 seconds.
    * I no longer output the debug output for animation and brightness
    encoder changes.
    * power and log tables are no longer static members of the
    AnimationBase class and are instead hidden inside the Animation.cpp
    module as static globals that can be called by code outside of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
    [Animation.cpp, Animation.h, main.cpp]
2018-10-04 Enable speed selection encoder
    The middle rotary encoder can now be used to change the speed of the
    LED animations. Clockwise rotations speed up the animations and
    counterclockwise slow them down. The only animations not affected by
    this change are the solid ones (which don't animate) and the candle
    flicker animation.
2018-10-05 Add running lights animation
    Derived from code at the following link:
    https://www.tweaking4all.com/hardware/arduino/adruino-led-strip-effects/#LEDStripEffectRunningLights
2018-10-05 Add snow sparkle animation
    Modified the existing twinkle animation to support the snow sparkle
    animation from this link:
    https://www.tweaking4all.com/hardware/arduino/adruino-led-strip-effects/#LEDStripEffectSnowSparkle
2018-10-05 Add snowfall/meteor animation
    This is a port of the meteor animation found at this link:
    https://www.tweaking4all.com/hardware/arduino/adruino-led-strip-effects/#LEDStripEffectMeteorRain
    On the tree, when run from the top to the bottom, it kind of looks like
    snow falling down the tree.
2018-10-05 Slow down candle flicker animation
    The candle flicker animation was previously strobing too fast. This
    commit slows down the flicker and makes it a little more subtle.
    [Animation.cpp, main.cpp]
2018-11-27 Update hsvToRgb() to use some floating point
    I switched out an integer multiply with a floating point multiply so
    that a remainder of 42 (the maximum remainder) will be scaled to 255
    instead of 252. This allows pure green to be converted from RGB to HSV
    and back without any red being introduced.
2020-11-04 Increase NeoPixel reset time to 300usec
    I switched the tree to use the following premade set of NeoPixel lights
    and it wouldn't work until I made this change in the reset time:
    https://www.amazon.com/WESIRI-Diffused-Individually-Addressable-Waterproof/dp/B075T84ZR3
    I didn't see in the WS281x datasheet where this was required (it
    indicated 50usec) but I did see this increased value in the Adafruit
    version of the library and once I tried it in mine, it got started
    working with the newer LEDs.
    [NeoPixel.cpp]
