adamgreen/NeoPixelTree/(notices)

Notices in the files:
parts and their libraries:
SparkFun-DigitalIC: Licensing: Creative Commons ShareAlike 4.0 International - https://creativecommons.org/licenses/by-sa/4.0
adam_custom: Creative Commons Attribution-Share Alike 4.0 License Document Field
